ryanlederhose/Quadrature-Encoder-Test-Kit/hardware/README.md

# Hardware

This folder contains files relating to hardware.

* Schematics and 3D PCB Prints
* Gerber files for PCB fabrication
* Bill of materials
