ryanlederhose/Quadrature-Encoder-Test-Kit/hardware/bom.xlsx

Part Name | URL | Cost | Quantity
STM32F411 BlackPill Development Board | STM32F411 BlackPill Development Board | DFRobot DFR0864 | Core Electronics Australia (core-electronics.com.au) (https://core-electronics.com.au/stm32f411-blackpill-development-board-49034.html) | $29.85 | 1
LM1117T-5.0/NOPB | LM1117T-5.0/NOPB Texas Instruments | Integrated Circuits (ICs) | DigiKey (https://www.digikey.com.au/en/products/detail/texas-instruments/LM1117T-5-0-NOPB/363594) | $2.74 | 1
Breadboard-friendly 2.1mm DC barrel jack | Breadboard-friendly 2.1mm DC barrel jack | Adafruit ADA373 | Core Electronics Australia (core-electronics.com.au) (https://core-electronics.com.au/breadboard-friendly-2-1mm-dc-barrel-jack.html) | $2.10 | 1
CONN HDR 10POS 0.1 GOLD PCB 6PC | 920-0087-01 Schmartboard, Inc. | Connectors, Interconnects | DigiKey (https://www.digikey.com.au/en/products/detail/schmartboard-inc/920-0087-01/9559415) | $8.11 | 1
CONN RCPT 1POS GOLD PCB | SSW-101-01-G-S Samtec Inc. | Connectors, Interconnects | DigiKey (https://www.digikey.com.au/en/products/detail/samtec-inc/SSW-101-01-G-S/1112106) | $0.63 | 4
Fermion: 1.8" 128x160 IPS TFT LCD Display with MicroSD Card Slot (Breakout) | Fermion: 1.8" 128x160 IPS TFT LCD Display with MicroSD Card Slot (Breakout) | DFRobot DFR0928 | Core Electronics Australia (core-electronics.com.au) (https://core-electronics.com.au/fermion-18-128x160-ips-tft-lcd-display-with-microsd-card-slot-breakout.html) | $14.95 | 1
TERM BLOCK PLUG 8POS 5.08MM | 1792812 Phoenix Contact | Connectors, Interconnects | DigiKey (https://www.digikey.com.au/en/products/detail/phoenix-contact/1792812/260436) | $14.49 | 1
8 Pole PC Mount Pluggable Header - 5.08mm - Horizontal | 8 Pole PC Mount Pluggable Header - 5.08mm - Horizontal | Jaycar Electronics (https://www.jaycar.com.au/8-pole-pc-mount-pluggable-header-5-08mm-horizontal/p/HM3108) | $4.45 | 1
 |  | $79.21
