ryanlederhose/Quadrature-Encoder-Test-Kit/hardware/Assembly.PDF

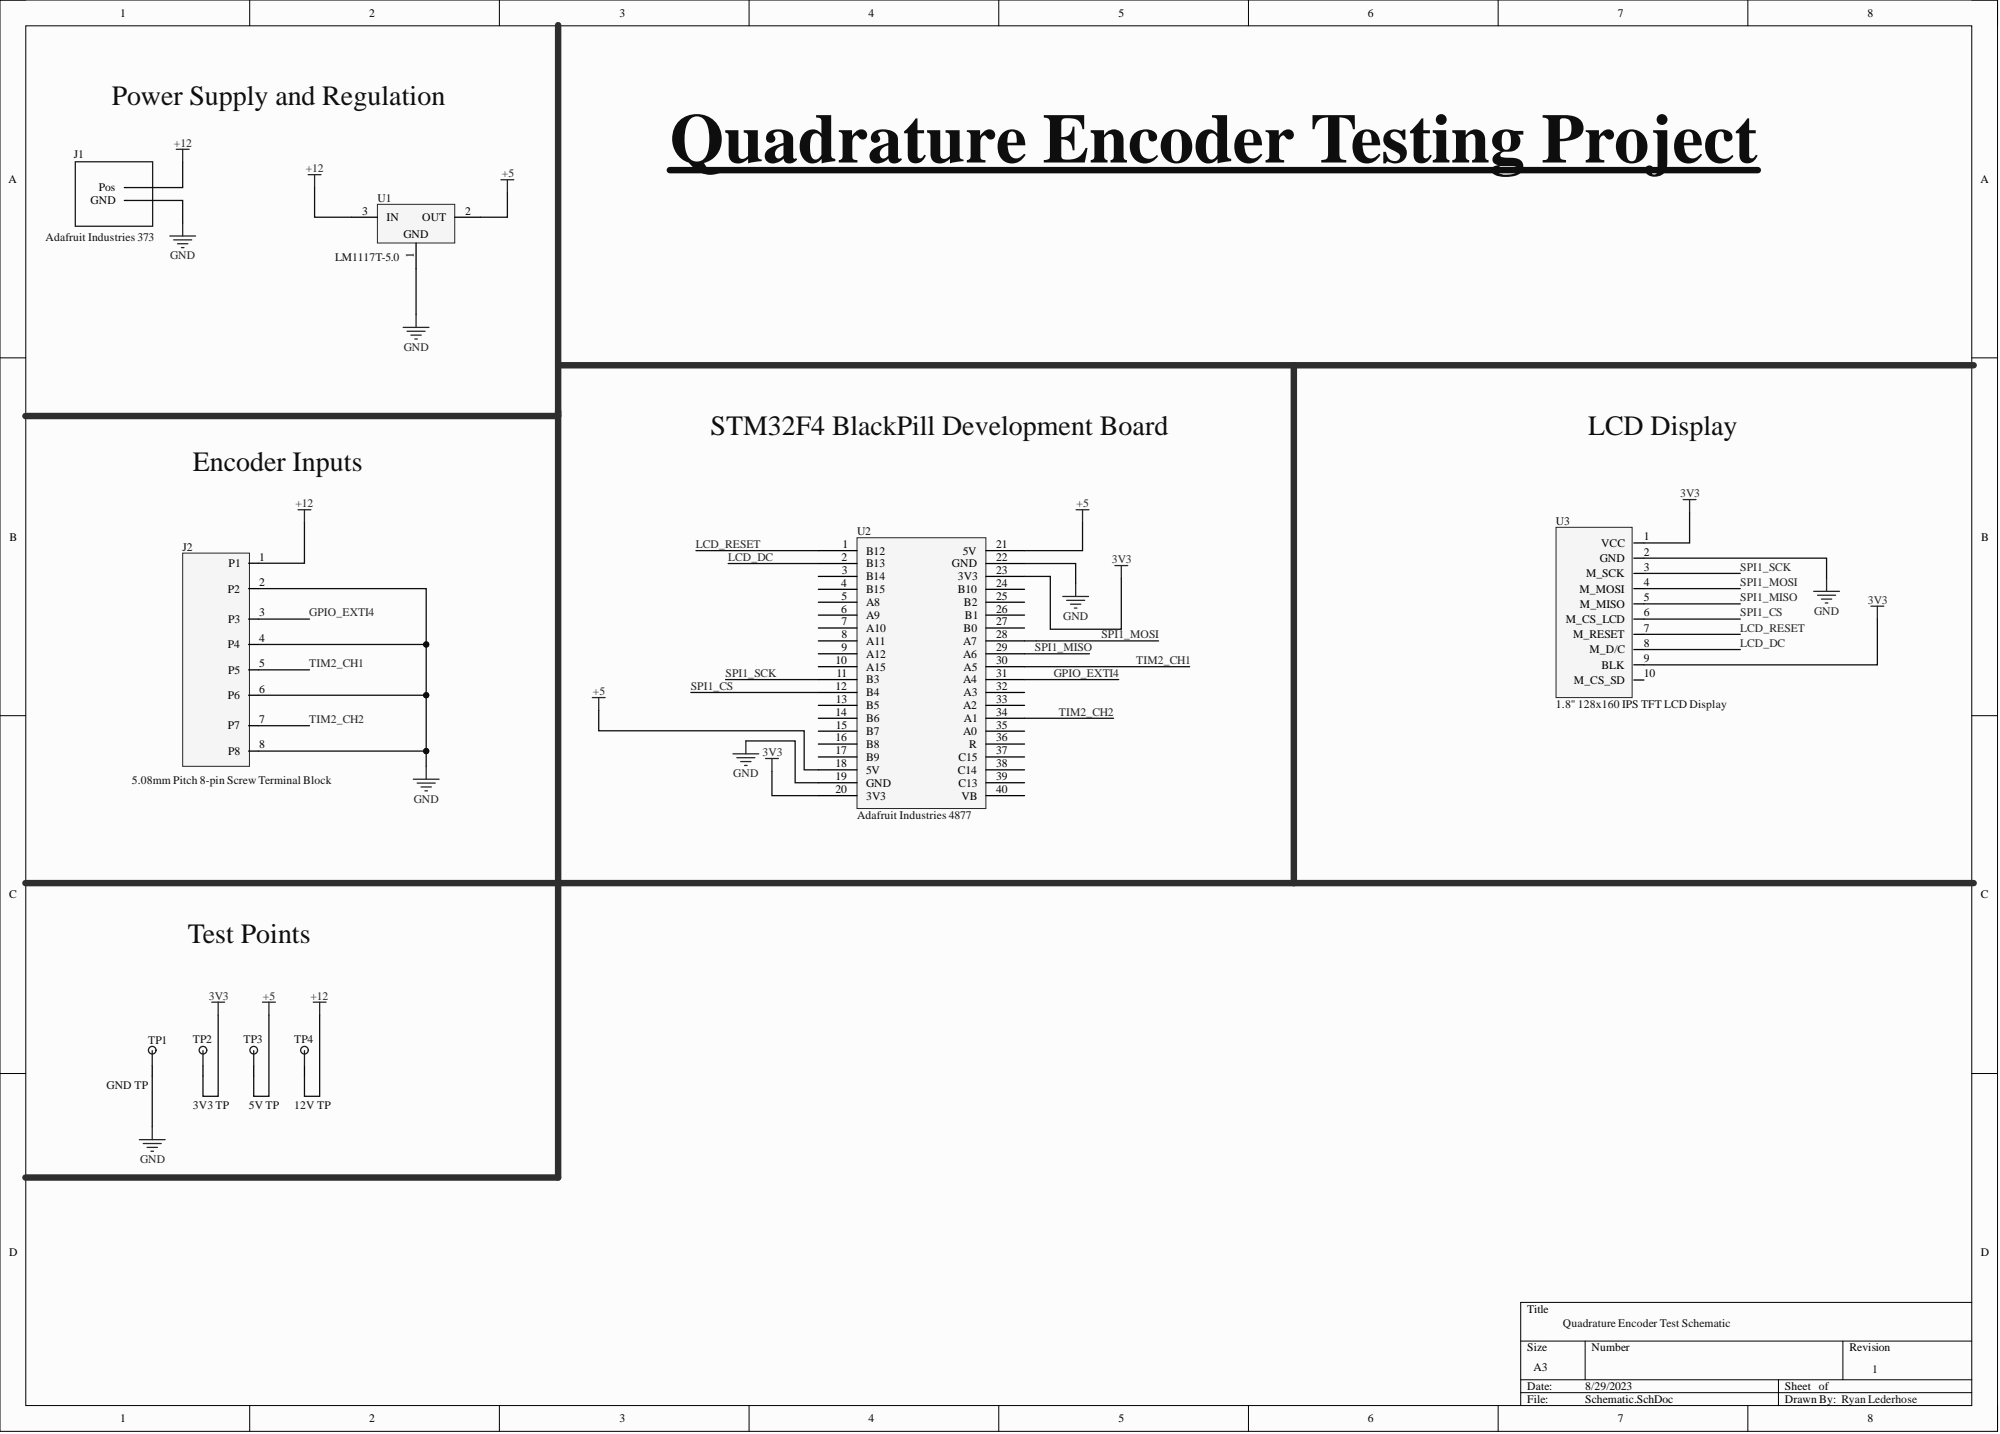
[picture p13: page 1]

Quadrature Encoder Testing Project

Power Supply and Regulation

1.8" 128x160 IPS TFT LCD Display

5.08mm Pitch 8-pin Screw Terminal Block

Quadrature Encoder Test Schematic

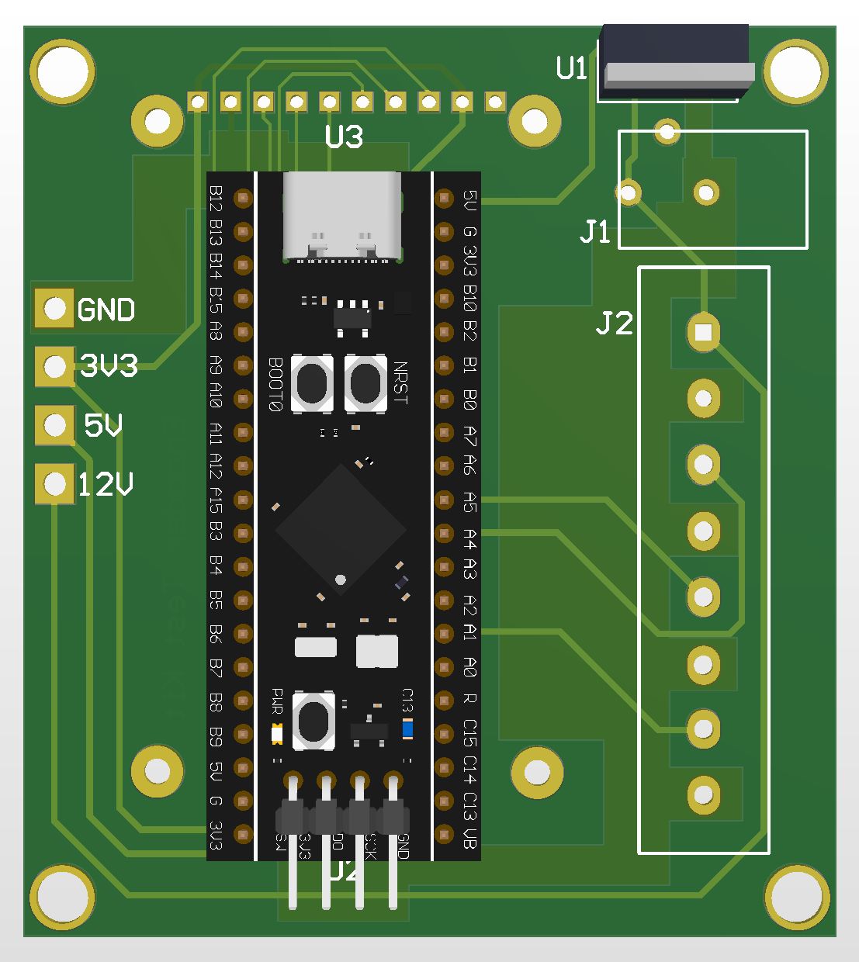
[picture p14: page 2]
