ryanlederhose/Quadrature-Encoder-Test-Kit/hardware/Fabrication.PDF

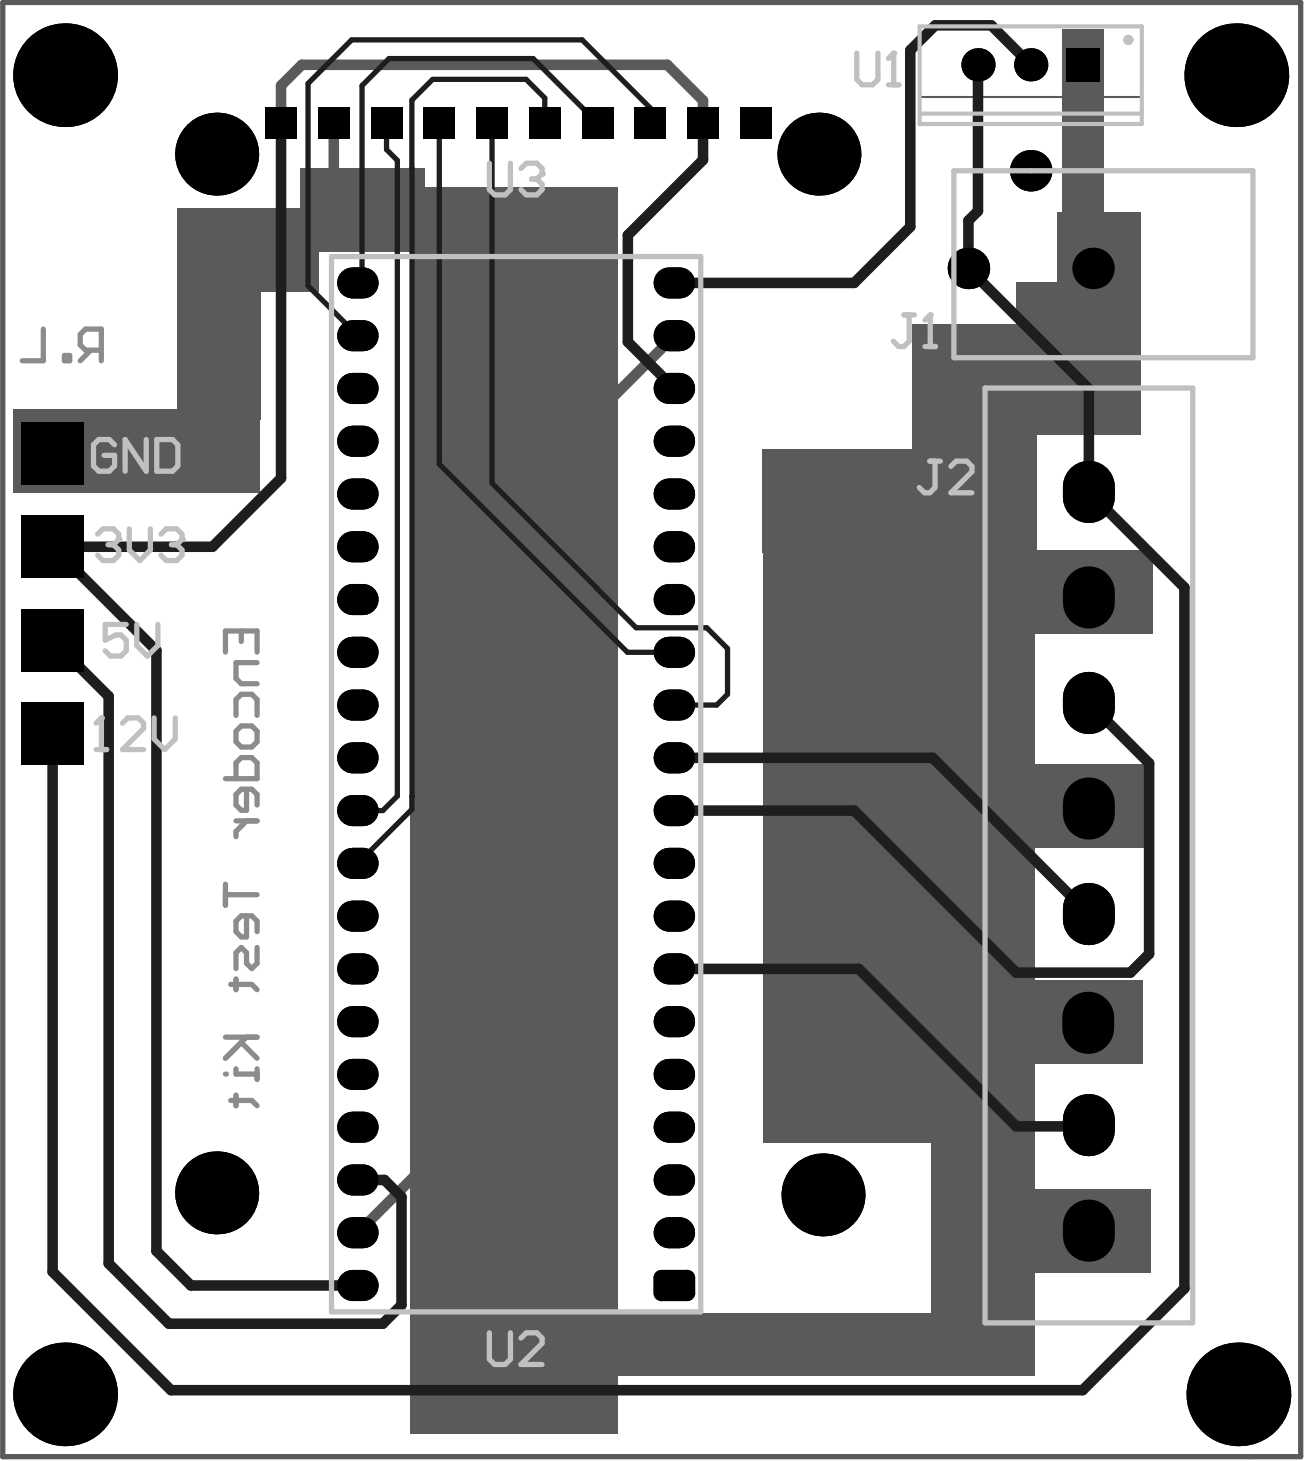
[picture p15: page 1]
