ryanlederhose/Quadrature-Encoder-Test-Kit/embedded/quadrature-decoder/Core/Inc/main.h

#define NO_ROTATION 0
#define CW_ROTATION 1
#define CCW_ROTATION 2
#define CYAN    0x07FF
#define MAGENTA 0xF81F
#define YELLOW  0xFFE0
#define WHITE   0xFFFF
#define MAX_SIZE 150
#define LCD_RESET_Pin GPIO_PIN_12
#define LCD_RESET_GPIO_Port GPIOB
#define LCD_DC_Pin GPIO_PIN_13
#define LCD_DC_GPIO_Port GPIOB
#define SPI1_CS_Pin GPIO_PIN_4
#define SPI1_CS_GPIO_Port GPIOB
