ryanlederhose/Quadrature-Encoder-Test-Kit/(commit log)

2023-07-17 source files
    [quadrature-decoder Debug.cfg]
2023-08-30 hardware files
    [bom.xlsx]
